Heavy-Vehicle-Networking-At-U-Tulsa/NMFTA-CAN-Logger/docs/AssembledPrototype.jpg

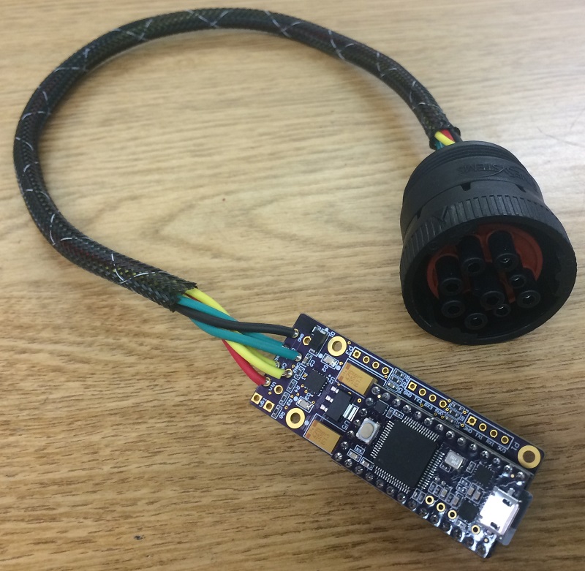
docs/AssembledPrototype.jpg
