Heavy-Vehicle-Networking-At-U-Tulsa/NMFTA-CAN-Logger/docs/BottomSideOfCANLoggerBoard.jpg

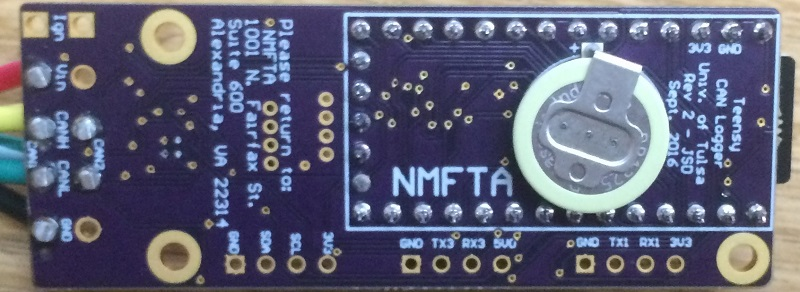
docs/BottomSideOfCANLoggerBoard.jpg
