Heavy-Vehicle-Networking-At-U-Tulsa/NMFTA-CAN-Logger/docs/Heavy Vehicle CAN Data Logger Collection Worksheet.docx

# Heavy Vehicle CAN Data Logger Collection Worksheet

Please fill out this data to assist in properly classifying the data contained on the SD Card with CAN data.

1. CAN Logger Serial number (e.g. TU01):
2. Vehicle Model Year: (YYYY)
3. Manufacture Date (e.g. Feb 09)
4. Vehicle Make (e.g. Freightliner)
5. Vehicle Model (e.g. Cascadia)
6. VIN: (17 Digits)
7. Engine Make (e.g. Detroit Diesel)
8. Engine Model (e.g. Series 60)
9. Engine Serial Number (e.g. 06R112345)
10. Brake Controller Make (e.g. Bendix)
11. Brake Controller Model (e.g. EC-60 ABS,PLC)
12. Brake Controller Serial Number (Optional)
13. Transmission Make (e.g. Eaton Fuller)
14. Transmission Model (e.g. RTLO-16713A)
15. Trans. Serial Number (Optional)
16. Telematics Make (e.g. Omnitracs)
17. Telematics Mode (e.g. MCP-200)
18. Telematics serial number (optional)
19. Date of installation: (MM/DD/YYYY)
20. Time of installation: (HH:MM am/pm tZone)
21. Date of removal: (MM/DD/YYYY)
22. Time of removal: (HH:MM am/pm tZone)
23. Approximate distance driven (miles)
24. Point of Contact for any questions
25. Point of Contact phone number:
26. Interesting facts about the test:

# LED Indicators and Troubleshooting

Data is being collected when the green LED is blinking. If the Red LED is flashing, there is an error. In case of an error, please insert the SD card and try again. If the Red LED stays on solid, even though there should be CAN data, the SD card may be full. Please try another SD card.

## Please Return To:

Urban K. Jonson
Chief Technology Officer
National Motor Freight Traffic Association, Inc.
1001 N. Fairfax St., Suite 600
Alexandria, VA 22314
E-mail: urban.jonson@nmfta.org
Phone: +1 (703) 838-1828

Using FexEx or UPS, please mail the SD cards. The cards will be returned.

GitHub\NMFTA-CAN-Logger\docs\Heavy Vehicle CAN Data Logger Collection Worksheet.docx
