Heavy-Vehicle-Networking-At-U-Tulsa/NMFTA-CAN-Logger/Utilities/Utility_Read_SD_Binaries_in_Python/TU02_001_signals.png

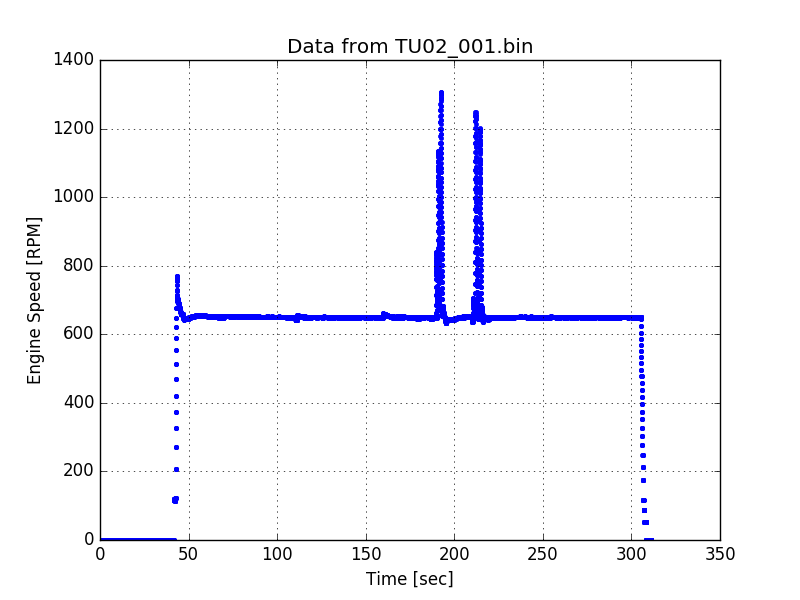
Utilities/Utility_Read_SD_Binaries_in_Python/TU02_001_signals.png
