Heavy-Vehicle-Networking-At-U-Tulsa/NMFTA-CAN-Logger/docs/TeensyCANLogger.pdf

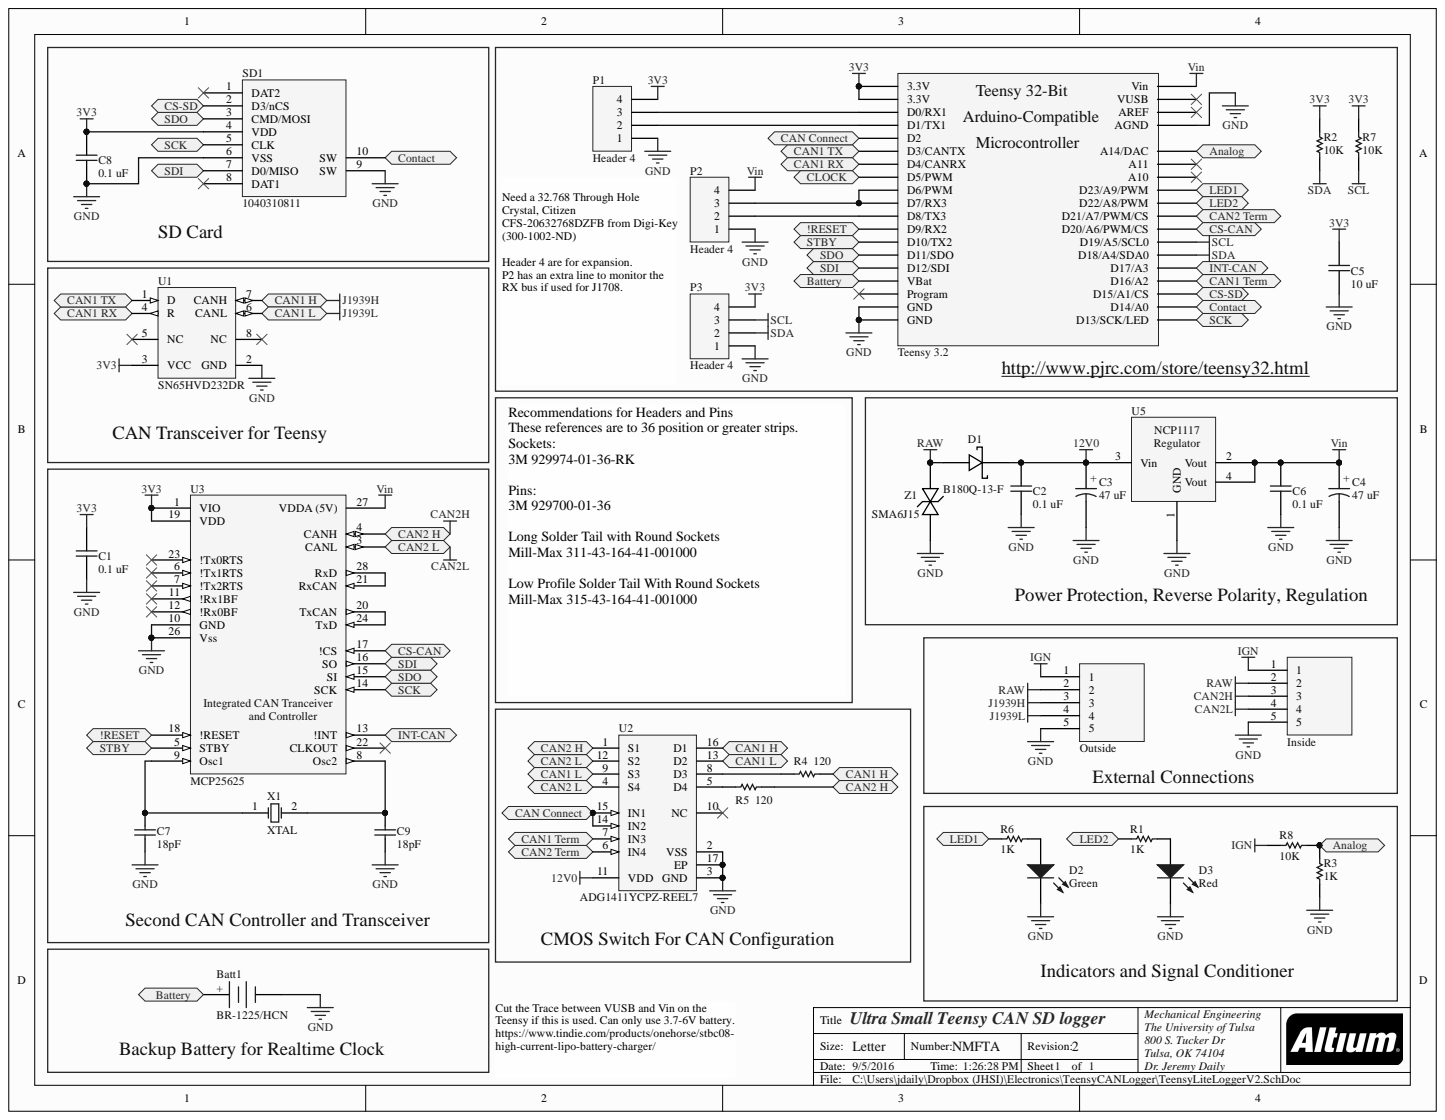
[picture p5: page 1]

Need a 32.768 Through Hole
Crystal, Citizen
CFS-20632768DZFB from Digi-Key

Header 4 are for expansion.
P2 has an extra line to monitor the
RX bus if used for J1708.

http://www.pjrc.com/store/teensy32.html

Recommendations for Headers and Pins
These references are to 36 position or greater strips.
Sockets:

RAW CAN Transceiver for Teensy

Long Solder Tail with Round Sockets
Mill-Max 311-43-164-41-001000

Low Profile Solder Tail With Round Sockets
Mill-Max 315-43-164-41-001000

Power Protection, Reverse Polarity, Regulation

Second CAN Controller and Transceiver

CMOS Switch For CAN Configuration

GND
Indicators and Signal Conditioner

Cut the Trace between VUSB and Vin on the
Teensy if this is used. Can only use 3.7-6V battery.
https://www.tindie.com/products/onehorse/stbc08-
high-current-lipo-battery-charger/

Ultra Small Teensy CAN SD logger Title | Mechanical Engineering The University of Tulsa 800 S. Tucker Dr Tulsa, OK 74104 Dr. Jeremy Daily

Backup Battery for Realtime Clock

Letter Size: | NMFTA Number: | 2 Revision:
Date: 9/5/2016 Time: 1:26:28 PM | | Sheet 1 of 1

C:\Users\jdaily\Dropbox (JHSI)\Electronics\TeensyCANLogger\TeensyLiteLoggerV2.SchDoc

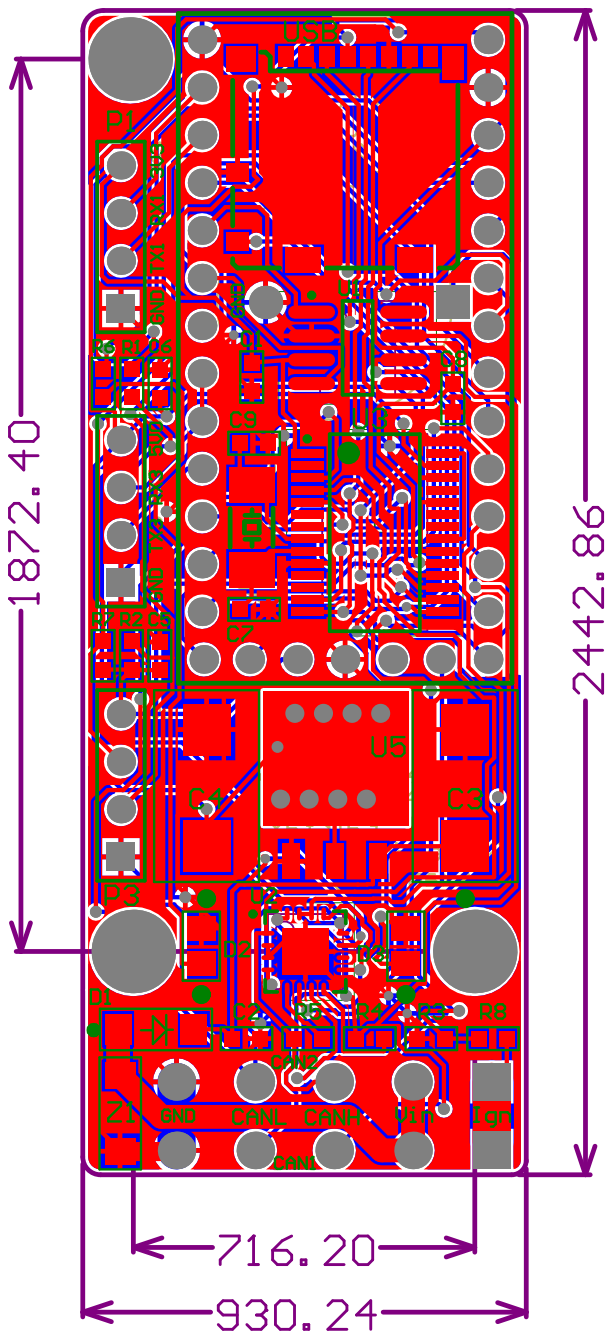
[picture p6: page 2]

Item#C#olumn Name Error:Manufac#Column Name Error:Manufacturer No | Quantity | #Column Name Error:Note | Designator | Description | Footprint | Comment | #Column Name Error:LibRe
1 | 1 | Batt1 | Lithium Battery Non-Rechargeable (Primary) 3V Coin, 12.5mm | BR-1225/HCN Coin Cell | BR-1225/HCN
2 | 1 | BRD1 | 32 Bit Arduino-Compatible Microcontroller Headers x 2 with 5 Pos | Teensy | Teensy 3.2
3 | 4 | C1, C2, C6, C8 | CAP CER 0.1UF 50V X7R 0603 | 0603 | 0.1 uF
4 | 2 | C3, C4 | Tantalum Capacitors - Solid SMD 35volts 47uF 10% ESR=300mOhms | 2917 | 47 uF
5 | 1 | C5 | 10µF 6.3V Ceramic Capacitor X5R 0603 (1608 Metric) 0.063" L x 0.031" W (1.60mm x 0.80mm) | 0603 | 10 uF
6 | 2 | C7, C9 | CAP CER 18PF 50V 5% NP0 0603 | 0603 | 18pF
7 | 1 | D1 | Diode Schottky 80V 1A Surface Mount SMA | SMA with A and K | B180Q-13-F
8 | 1 | D2 | Green 570nm LED Indication - Discrete 2.2V 0805 (2012 Metric) | 0805 Polarized | Green
9 | 1 | D3 | Red 633nm LED Indication - Discrete 2V 0805 (2012 Metric) | 0805 Polarized | Red
10 | 1 | J6 | Molex Mint Fit Jr 5 CKT VERT HEADER | 5 POS Vert MINI-FIT JR | Outside
11 | 1 | J7 | Molex Mint Fit Jr 5 CKT VERT HEADER | 5 POS Vert MINI-FIT JR | Inside
12 | 3 | P1, P2, P3 | Header, 4-Pin | HDR1X4 | Header 4
13 | 3 | R1, R3, R6 | RES SMD 1K OHM 1% 1/10W 0603 | 0603 | 1K
14 | 3 | R2, R7, R8 | RES SMD 10K OHM 1% 1/10W 0603 | 0603 | 10K
15 | 2 | R4, R5 | RES SMD 120 OHM 1% 1/10W 0603 | 0603 | 120
16 | 1 | SD1 | Molex 1040310811 | SD Holder Push-pull | 1040310811
17 | 1 | U1 | 1/1 Transceiver Half CAN 8-SOIC | D8_M | SN65HVD232DR
18 | 1 | U2 | 1.5 Ohm on Resistance, +/-15 V / +12 V / +/-5 V, iCMOS, Quad SPST Switch, 16-pin QFN (CP-16-13), Reel | ADI-CP-16-13_N | ADG1411YCPZ-REEL7
19 | 1 | U3 | CAN Interface IC CAN Controller with Int. Transceiver 28-SSOP | SOP65P780X200-28N | MCP25625
20 | 1 | U5 | Linear Voltage Regulator IC Positive Fixed 1 Output 5V 1A SOT-223 | SOT-223 | LDO1117
21 | 1 | X1 | CRYSTAL 16MHZ 18PF SMD | XTAL 2 pad | XTAL
22 | 1 | Z1 | TVS DIODE 15VWM 24.4VC SMA | SMA | SMA6J15
