Heavy-Vehicle-Networking-At-U-Tulsa/NMFTA-CAN-Logger/Utilities/Utility_Read_SD_Binaries_in_Python/TU02_001_signals_zoomed.pdf

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

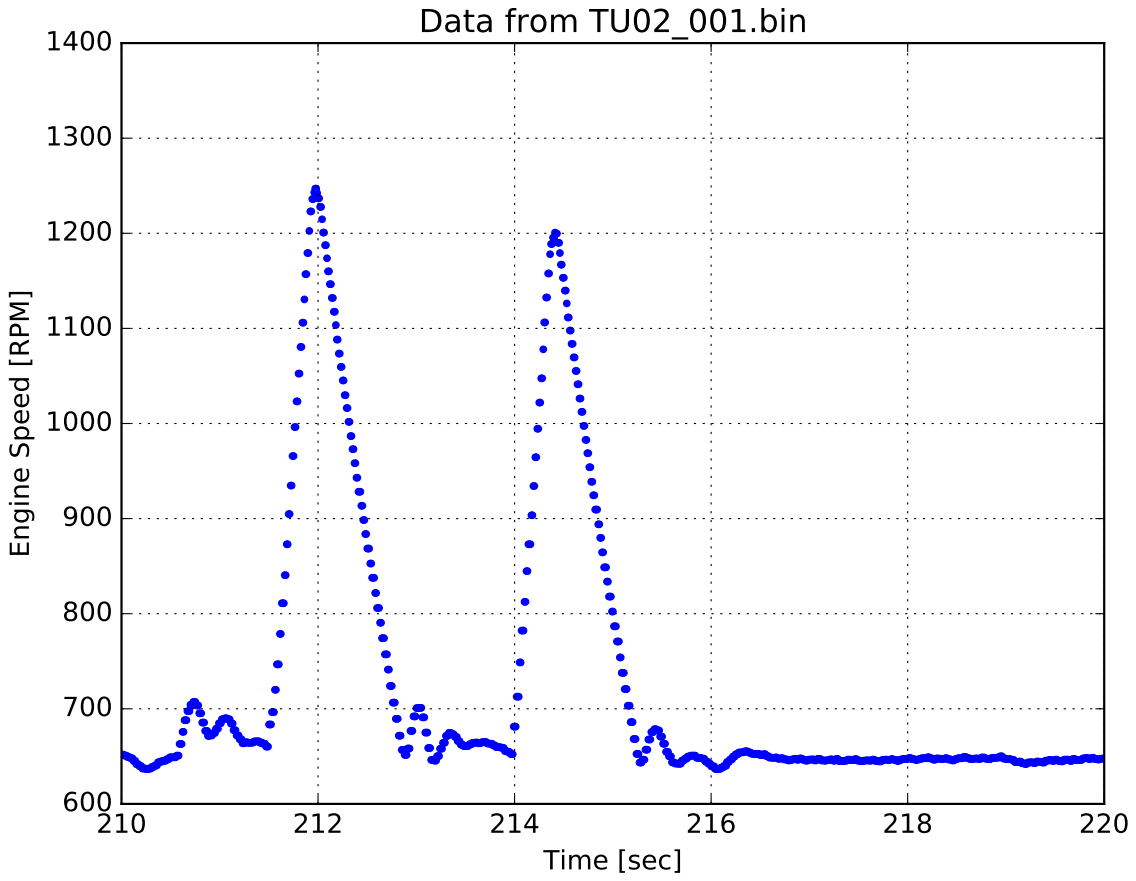
[picture p8: page 1]
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
