Heavy-Vehicle-Networking-At-U-Tulsa/NMFTA-CAN-Logger/_07_Low_Latency_Logger_with_Requests/_07_Low_Latency_Logger_with_Requests.ino

/*
 * NMFTA CAN Logger Project
 * 
 * Arduino Sketch to test the ability to receive CAN messages
 * 
 * Written By Dr. Jeremy S. Daily
 * The University of Tulsa
 * Department of Mechanical Engineering
 * 
 * 29 September 2016
 * 
 * Released under the MIT License
 *
 * Copyright (c) 2016        Jeremy S. Daily
 *
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
 * 
 * This program logs data to a binary file.  Functions are included
 * to convert the binary file to a csv text file.
 *
 * Samples are logged at regular intervals.  The maximum logging rate
 * depends on the quality of your SD card. 
 * 
 * Data is written to the file using a SD multiple block write command.
 * 
 * Much of this sketch was inspired by the examples from https://github.com/greiman/SdFat
 * 
 */

// log file base name.  Must be five characters or less. Change this line for each upload
// The first four characters should match the label on the cable.
#define FILE_BASE_NAME "TU01_"

//included libraries 
#include <SPI.h>
#include <SdFat.h>
#include <SdFatUtil.h>
//#include <StdioStream.h>
#include <FlexCAN.h>
#include <TimeLib.h>

// User data functions.  Modify these functions for your data items.
// Edit this include file to change data_t.
#include "UserDataType.h"  

const int millisBetweenRequests = 5000;

#define numRequests 4
const uint16_t PGNRequestList[numRequests] = {
  //65261, // Cruise Control/Vehicle Speed Setup
  //65214, // Electronic Engine Controller 4
  65259, // Component Identification
  65242, // Software Identification
  //65244, // Idle Operation
  65260, // Vehicle Identification
  //65255, // Vehicle Hours
  //65253, // Engine Hours, Revolutions
  //65257, // Fuel Consumption (Liquid)
  //65256, // Vehicle Direction/Speed
  //65254, // Time/Date
  //65211, // Trip Fan Information
  //65210, // Trip Distance Information
  //65209, // Trip Fuel Information (Liquid)
  //65207, // Engine Speed/Load Factor Information
  //65206, // Trip Vehicle Speed/Cruise Distance Information
  //65205, // Trip Shutdown Information
  //65204, // Trip Time Information 1
  //65200, // Trip Time Information 2
  //65250, // Transmission Configuration
  //65203, // Fuel Information (Liquid)
  //65201, // ECU History
  //65168, // Engine Torque History
  //64981, // Electronic Engine Controller 5
  //64978, // ECU Performance
  64965, // ECU Identification Information
  //65165  // Vehicle Electrical Power #2
};

uint8_t pgnIndex = 0;

#define numBaudRates 4
uint32_t baudRateList[numBaudRates] = {250000,500000,125000,1000000}; 
uint32_t baudrate = 250000; //default (may be overwritten with autobaud detection)

static CAN_message_t rxmsg,txmsg;

elapsedMicros microsecondsPerSecond;
elapsedMillis lastCANmessageTimer;
elapsedMillis LEDblinkTimer;
elapsedMillis requestTimer;

boolean redLEDstate;
boolean greenLEDstate;

//set up a display buffer
char displayBuffer[100]; 
char serialInput;

//Pin Definitions (See Schematics)
// SD chip select pin.
const uint8_t SD_CS_PIN = 15;

// Reset pin 
const uint8_t MCP_RESET_PIN = 9;

// standBy pin 
const uint8_t MCP_STDBY_PIN = 10;

// chip select pin 
const uint8_t MCP_CS_PIN = 20;

// chip select pin 
const uint8_t MCP_INT_PIN = 17;

// SD Card Contact Pin 
const uint8_t SD_CONTACT_PIN = 14;

//CAN Connect Pins
const uint8_t CAN_CONNECT_PIN = 2;
const uint8_t CAN1_TERMINATION_PIN = 16;
const uint8_t CAN2_TERMINATION_PIN = 21;

// The led blinks for fatal errors. The led goes on solid for SD write
// overrun errors and logging continues.
const uint8_t ERROR_LED_PIN = 22;
const uint8_t GREEN_LED_PIN = 23;


// Acquire a data record.
void acquireCANData(data_t* data) {
  data->timeStamp = now();
  data->usec = micros();
  data->ID =  rxmsg.id; 
  data->DLC = (rxmsg.len << 24) | (0x00FFFFFF & uint32_t(microsecondsPerSecond)); //This structure condenses storage
  memset(data->dataField,0xFF,8); //Set to 0xFF if not used.
  for (uint8_t i = 0; i < rxmsg.len; i++){
    data->dataField[i] = rxmsg.buf[i];  
  }
}

// Print a data record.
void printData(Print* pr, data_t* data) {
  time_t recordTime = data->timeStamp;
  uint32_t usecPerSec = data->DLC & 0x00FFFFFF;
  char timeString[100];
  sprintf(timeString,"%04d-%02d-%02d,%02d:%02d:%02d.%06d,",year(recordTime),month(recordTime),day(recordTime),hour(recordTime),minute(recordTime),second(recordTime),usecPerSec);
  pr->print(timeString);
  
  sprintf(timeString,"%10d.%06d,",data->timeStamp,usecPerSec);
  pr->print(timeString);
  
  pr->print(data->usec);
   
  char IDString[12];
  sprintf(IDString,",%08X,",data->ID);
  pr->print(IDString);
  pr->print((data->DLC & 0xFF000000) >> 24);
  for (int i = 0; i < 8; i++) {
    char entry[5];
    sprintf(entry,",%02X",data->dataField[i]);
    pr->print(entry);
  }
  pr->println();
}

// Print data header.
void printHeader(Print* pr) {
  pr->print(F("YYYY-MM-DD,HH:MM:SS.usec,"));
  pr->print(F("Unix timeStamp,"));
  pr->print(F("System uSecs,"));
  pr->print(F("ID,"));
  pr->print(F("DLC"));
  for (uint8_t i = 0; i < 8; i++) {
    pr->print(F(",B"));
    pr->print(i);
  }
  pr->println();
}



//------------------------------------------------------------------------------
// File definitions.
//
// Maximum file size in blocks.
// The program creates a contiguous file with FILE_BLOCK_COUNT 512 byte blocks.
// This file is flash erased using special SD commands.  The file will be
// truncated if logging is stopped early.
//const uint32_t FILE_BLOCK_COUNT = 256;
//const uint32_t FILE_BLOCK_COUNT = 2097152; //1 GB
const uint32_t FILE_BLOCK_COUNT = 4194304; //2 GB
//const uint32_t FILE_BLOCK_COUNT = 8388607; //4 GB - 512



//------------------------------------------------------------------------------
// Buffer definitions.
//
// The logger will use SdFat's buffer plus BUFFER_BLOCK_COUNT additional
// buffers.
//
#ifndef RAMEND
// Assume ARM. Use total of nine 512 byte buffers.
const uint8_t BUFFER_BLOCK_COUNT = 8;
//
#elif RAMEND < 0X8FF
#error Too little SRAM
//
#elif RAMEND < 0X10FF
// Use total of two 512 byte buffers.
const uint8_t BUFFER_BLOCK_COUNT = 1;
//
#elif RAMEND < 0X20FF
// Use total of five 512 byte buffers.
const uint8_t BUFFER_BLOCK_COUNT = 4;
//
#else  // RAMEND
// Use total of 13 512 byte buffers.
const uint8_t BUFFER_BLOCK_COUNT = 12;
#endif  // RAMEND

// Temporary log file.  Will be deleted if a reset or power failure occurs.
char TMP_FILE_NAME[13] = "tmp_data.bin";

// Size of file base name.  Must not be larger than five.
const uint8_t BASE_NAME_SIZE = sizeof(FILE_BASE_NAME) - 1;

SdFat sd;
SdBaseFile binFile;

char binName[13] = FILE_BASE_NAME "000.bin";

// Number of data records in a block.
const uint16_t DATA_DIM = (512 - 4)/sizeof(data_t);

//Compute fill so block size is 512 bytes.  FILL_DIM may be zero.
const uint16_t FILL_DIM = 512 - 4 - DATA_DIM*sizeof(data_t);

struct block_t {
  uint16_t count;
  uint16_t overrun;
  data_t data[DATA_DIM];
  uint8_t fill[FILL_DIM];
};


/*
 * ------------------------------------------------------------------------------
 * Function: getBaudRate
 * 
 * returns one of the predefined CAN bauds rates
 * 
 * This function will always run until a CAN message is received. Therefore, the first messages may not be captured if
 * the program starts on a live bus. 
*/
uint32_t getBaudRate() {
  rxmsg.timeout = 100;
  digitalWrite(LED_BUILTIN,HIGH);
  while (1){
    processSetTimeUtility();
    for(uint8_t i=0;i<numBaudRates;i++){
      uint32_t baudrate = baudRateList[i];
      Serial.print(F("Trying Baudrate of "));
      Serial.println(baudrate);
      FlexCAN testBus(baudrate);
      //Serial.println(F("Beginning test."));
      testBus.begin();
      if(testBus.read(rxmsg)){
        Serial.print("Baudrate is confirmed to be ");
        Serial.println(baudrate);
        digitalWrite(LED_BUILTIN,LOW);
        return baudrate;
      }
      else{
       testBus.end();
      }
      //Serial.println(F("Trying again."));
    }   
  }
}


//------------------------------------------------------------------------------
/*
 * User provided date time callback function.
 * See SdFile::dateTimeCallback() for usage.
 */
void dateTime(uint16_t* FATdate, uint16_t* FATtime) {
  // User gets date and time from GPS or real-time
  // clock in real callback function

  // return date using FAT_DATE macro to format fields
  *FATdate = FAT_DATE(year(), month(), day());

  // return time using FAT_TIME macro to format fields
  *FATtime = FAT_TIME(hour(), minute(), second());
}


const uint8_t QUEUE_DIM = BUFFER_BLOCK_COUNT + 2;

block_t* emptyQueue[QUEUE_DIM];
uint8_t emptyHead;
uint8_t emptyTail;

block_t* fullQueue[QUEUE_DIM];
uint8_t fullHead;
uint8_t fullTail;

// Advance queue index.
inline uint8_t queueNext(uint8_t ht) {
  return ht < (QUEUE_DIM - 1) ? ht + 1 : 0;
}
//==============================================================================
// Error messages stored in flash.
#define error(msg) errorFlash(F(msg))
//------------------------------------------------------------------------------
void errorFlash(const __FlashStringHelper* msg) {
  sd.errorPrint(msg);
  fatalBlink();
}
//------------------------------------------------------------------------------
//
void fatalBlink() {
  while (true) {
    if (ERROR_LED_PIN >= 0) {
      digitalWrite(ERROR_LED_PIN, HIGH);
      delay(80);
      digitalWrite(ERROR_LED_PIN, LOW);
      delay(80);
      
    }
  }
}
//==============================================================================
// Convert binary file to csv file.
void binaryToCsv() {
  uint8_t lastPct = 0;
  block_t block;
  uint32_t t0 = millis();
  uint32_t syncCluster = 0;
  SdFile csvFile;
  char csvName[13];

  if (!binFile.isOpen()) {
    Serial.println();
    Serial.println(F("No current binary file"));
    return;
  }
  binFile.rewind();
  // Create a new csvFile.
  strcpy(csvName, binName);
  strcpy(&csvName[BASE_NAME_SIZE + 4], ".csv");

  if (!csvFile.open(csvName, O_WRITE | O_CREAT | O_TRUNC)) {
    error("open csvFile failed");
  }
  Serial.println();
  Serial.print(F("Writing: "));
  Serial.print(csvName);
  Serial.println(F(" - type any character to stop"));
  printHeader(&csvFile);
  uint32_t tPct = millis();
  while (!Serial.available() && binFile.read(&block, 512) == 512) {
     
    uint16_t i;
    if (block.count == 0) {
      break;
    }
    if (block.overrun) {
      csvFile.print(F("OVERRUN,"));
      csvFile.println(block.overrun);
    }
    for (i = 0; i < block.count; i++) {
      printData(&csvFile, &block.data[i]);
    }
    if (csvFile.curCluster() != syncCluster) {
      csvFile.sync();
      syncCluster = csvFile.curCluster();
    }
    if ((millis() - tPct) > 1000) {
      uint8_t pct = binFile.curPosition()/(binFile.fileSize()/100);
      if (pct != lastPct) {
        tPct = millis();
        lastPct = pct;
        Serial.print(pct, DEC);
        Serial.println('%');
      }
    }
    if (Serial.available()) {
      break;
    }
  }
  csvFile.close();
  Serial.print(F("Done: "));
  Serial.print(0.001*(millis() - t0));
  Serial.println(F(" Seconds"));
}
//------------------------------------------------------------------------------
// read data file and check for overruns
void checkOverrun() {
  bool headerPrinted = false;
  block_t block;
  uint32_t bgnBlock, endBlock;
  uint32_t bn = 0;

  if (!binFile.isOpen()) {
    Serial.println();
    Serial.println(F("No current binary file"));
    return;
  }
  if (!binFile.contiguousRange(&bgnBlock, &endBlock)) {
    error("contiguousRange failed");
  }
  binFile.rewind();
  Serial.println();
  Serial.println(F("Checking overrun errors - type any character to stop"));
  while (binFile.read(&block, 512) == 512) {
    if (block.count == 0) {
      break;
    }
    if (block.overrun) {
      if (!headerPrinted) {
        Serial.println();
        Serial.println(F("Overruns:"));
        Serial.println(F("fileBlockNumber,sdBlockNumber,overrunCount"));
        headerPrinted = true;
      }
      Serial.print(bn);
      Serial.print(',');
      Serial.print(bgnBlock + bn);
      Serial.print(',');
      Serial.println(block.overrun);
    }
    bn++;
  }
  if (!headerPrinted) {
    Serial.println(F("No errors found"));
  } else {
    Serial.println(F("Done"));
  }
}
//------------------------------------------------------------------------------
// dump data file to Serial
void dumpData() {
  block_t block;
  if (!binFile.isOpen()) {
    Serial.println();
    Serial.println(F("No current binary file"));
    return;
  }
  binFile.rewind();
  Serial.println();
  Serial.println(F("Type any character to stop"));
  delay(100);
  printHeader(&Serial);
  while (!Serial.available() && binFile.read(&block , 512) == 512) {
  
    if (block.count == 0) {
      break;
    }
    if (block.overrun) {
      Serial.print(F("OVERRUN,"));
      Serial.println(block.overrun);
    }
    for (uint32_t i = 0; i < block.count; i++) {
      printData(&Serial, &block.data[i]);
    }
  }
  Serial.println(F("Done"));
}


//------------------------------------------------------------------------------
// log data
// max number of blocks to erase per erase call
uint32_t const ERASE_SIZE = 262144L;
void logData(uint32_t baudrate) {
  digitalWrite(ERROR_LED_PIN,HIGH);
  FlexCAN CANbus(baudrate);
  CANbus.begin();
  rxmsg.timeout = 0;
  
  
  uint32_t bgnBlock, endBlock;
  lastCANmessageTimer = 0;
  
  // Allocate extra buffer space.
  block_t block[BUFFER_BLOCK_COUNT];
  block_t* curBlock = 0;
  Serial.println();

  // Find unused file name.
  if (BASE_NAME_SIZE > 5) {
    error("FILE_BASE_NAME too long");
  }
  while (sd.exists(binName)) {
    if (binName[BASE_NAME_SIZE + 2] != '9') {
      binName[BASE_NAME_SIZE + 2]++;
    }
    else {
      binName[BASE_NAME_SIZE + 2] = '0';
      if (binName[BASE_NAME_SIZE + 1] != '9') {
        binName[BASE_NAME_SIZE + 1]++;
      }
      else {
        binName[BASE_NAME_SIZE+1] = '0';
        binName[BASE_NAME_SIZE]++;
      }
    }
    
   if (binName[BASE_NAME_SIZE] == '9' & binName[BASE_NAME_SIZE+1] == '9' & binName[BASE_NAME_SIZE+2] == '9') {
        error("Can't create file name");
    }
  }
//  memset(TMP_FILE_NAME,0,sizeof(TMP_FILE_NAME));
//  for(uint8_t i = 0; i<8; i++){
//    TMP_FILE_NAME[i] = random(65,91);  
//  }
//  strncat(TMP_FILE_NAME, ".tmp",4);
  
  
  // Create new file.
  Serial.print(F("Creating new file "));
  Serial.println(TMP_FILE_NAME);
  binFile.close();
  if (!binFile.createContiguous(sd.vwd(),TMP_FILE_NAME, 512 * FILE_BLOCK_COUNT)) {
    error("createContiguous failed");
  }
  // Get the address of the file on the SD.
  if (!binFile.contiguousRange(&bgnBlock, &endBlock)) {
    error("contiguousRange failed");
  }
  // Use SdFat's internal buffer.
  uint8_t* cache = (uint8_t*)sd.vol()->cacheClear();
  if (cache == 0) {
    error("cacheClear failed");
  }

  // Flash erase all data in the file.
  Serial.println(F("Initializing Temporary File"));
  uint32_t bgnErase = bgnBlock;
  uint32_t endErase;
  while (bgnErase < endBlock) {
    endErase = bgnErase + ERASE_SIZE;
    if (endErase > endBlock) {
      endErase = endBlock;
    }
    if (!sd.card()->erase(bgnErase, endErase)) {
      error("erase failed");
    }
    bgnErase = endErase + 1;
  }
  // Start a multiple block write.
  if (!sd.card()->writeStart(bgnBlock, FILE_BLOCK_COUNT)) {
    error("writeBegin failed");
  }
  // Initialize queues.
  emptyHead = emptyTail = 0;
  fullHead = fullTail = 0;

  // Use SdFat buffer for one block.
  emptyQueue[emptyHead] = (block_t*)cache;
  emptyHead = queueNext(emptyHead);

  // Put rest of buffers in the empty queue.
  for (uint8_t i = 0; i < BUFFER_BLOCK_COUNT; i++) {
    emptyQueue[emptyHead] = &block[i];
    emptyHead = queueNext(emptyHead);
  }

  //wait for a CAN message to show up
  Serial.println(F("Waiting for CAN Messages..."));
  while (CANbus.read(rxmsg) == 0) processSetTimeUtility(); //Set up the ability to set the realtime clock while waiting for a CAN message
  Serial.println(F("CAN Message Found."));
  Serial.println(F("Logging - type any character to stop"));
  // Wait for Serial Idle.
  Serial.flush();
  //while(Serial.available()) Serial.read();
  delay(10);
  uint32_t bn = 0;
  uint32_t t0 = millis();
  uint32_t t1 = t0;
  uint32_t overrun = 0;
  uint32_t overrunTotal = 0;
  uint32_t count = 0;
  uint32_t maxLatency = 0;
  int32_t diff;
//  // Start at a multiple of interval.
//  uint32_t logTime = micros()/LOG_INTERVAL_USEC + 1;
//  logTime *= LOG_INTERVAL_USEC;
  bool closeFile = false;

  
  digitalWrite(GREEN_LED_PIN,HIGH);
  digitalWrite(ERROR_LED_PIN,LOW);
  
  while (1) {
    if (Serial.available()) {
      closeFile = true;
      serialInput = Serial.read();
    }

    if (closeFile) {
      
      
      if (curBlock != 0 && curBlock->count >= 0) {
        // Put buffer in full queue.
        fullQueue[fullHead] = curBlock;
        fullHead = queueNext(fullHead);
        curBlock = 0;
      }
    } 
    else
    {
      if (curBlock == 0 && emptyTail != emptyHead) {
        curBlock = emptyQueue[emptyTail];
        emptyTail = queueNext(emptyTail);
        curBlock->count = 0;
        curBlock->overrun = overrun;
        overrun = 0;
      }

      if (curBlock == 0) {
        overrun++;
        Serial.print(F("Overrun: "));
        Serial.println(overrun);
      } 
      else 
      {
        if (CANbus.read(rxmsg)){
          acquireCANData(&curBlock->data[curBlock->count++]);
          lastCANmessageTimer = 0;

        }
        
        if (requestTimer >= millisBetweenRequests) {
          requestTimer = 0;
          uint16_t pgnToRequest = PGNRequestList[pgnIndex];
          pgnIndex++;
          if (pgnIndex > numRequests ) pgnIndex = 0;
      
          txmsg.ext = 1;
          txmsg.id = 0x18EA00F9; //request PGN
          txmsg.buf[0] = (pgnToRequest & 0x0000FF);
          txmsg.buf[1] = (pgnToRequest & 0x00FF00) >> 8 ;
          txmsg.buf[2] = (pgnToRequest & 0xFF0000) >> 16; //These are in reverse byte order.
          txmsg.len = 3;
          CANbus.write(txmsg);
        }
        
        if (LEDblinkTimer >= 500){
          LEDblinkTimer = 0; 
          greenLEDstate = !greenLEDstate;
          digitalWrite(GREEN_LED_PIN,greenLEDstate);
        }

        if (lastCANmessageTimer > 10000) closeFile = true; //Close the file after 10 seconds of CAN silence
        
        if (curBlock->count >= DATA_DIM) {
          //Serial.println(F("curBlock->count >= DATA_DIM"));
          fullQueue[fullHead] = curBlock;
          fullHead = queueNext(fullHead);
          curBlock = 0;
        }
      }
    }

    if (fullHead == fullTail) {
      //Serial.println(F("fullHead == fullTail"));
      // Exit loop if done.
      if (closeFile) {
        break;
      }
    } 
    else if (!sd.card()->isBusy()) {
      
      // Get address of block to write.
      block_t* pBlock = fullQueue[fullTail];
      fullTail = queueNext(fullTail);
      // Write block to SD.
      uint32_t usec = micros();
      if (!sd.card()->writeData((uint8_t*)pBlock)) {
        error("write data failed");
      }
      usec = micros() - usec;
      t1 = millis();
      if (usec > maxLatency) {
        maxLatency = usec;
      }
      count += pBlock->count;

      // Add overruns and possibly light LED.
      if (pBlock->overrun) {
        overrunTotal += pBlock->overrun;
        if (ERROR_LED_PIN >= 0) {
          digitalWrite(ERROR_LED_PIN, HIGH);
        }
      }
      // Move block to empty queue.
      emptyQueue[emptyHead] = pBlock;
      emptyHead = queueNext(emptyHead);
      bn++;
      if (bn == FILE_BLOCK_COUNT) {
        // File full so stop
        closeFile = true;
        break;
      }
    }
  }
  Serial.println(F("Closing Temp Buffer File."));
      
  if (!sd.card()->writeStop()) {
    error("writeStop failed");
  }
  digitalWrite(ERROR_LED_PIN, HIGH);
  digitalWrite(GREEN_LED_PIN, LOW);
  // Truncate file if recording stopped early.
  if (bn != FILE_BLOCK_COUNT) {
    Serial.println(F("Truncating file"));
    if (!binFile.truncate(uint32_t(512 * bn))) {
      error("Can't truncate file");
    }
  }
  if (!binFile.rename(sd.vwd(), binName)) {
    error("Can't rename file");
  }
  Serial.print(F("File renamed: "));
  Serial.println(binName);

  // Delete old tmp file.
  if (sd.exists(TMP_FILE_NAME)) {
    Serial.print(F("Deleting tmp file "));
    Serial.println(TMP_FILE_NAME);
    if (!sd.remove(TMP_FILE_NAME)) {
      error("Can't remove tmp file");
    }
  }
  
  Serial.print(F("Max block write usec: "));
  Serial.println(maxLatency);
  Serial.print(F("Record time sec: "));
  Serial.println(0.001*(t1 - t0), 3);
  Serial.print(F("Sample count: "));
  Serial.println(count);
  Serial.print(F("Samples/sec: "));
  Serial.println((1000.0)*count/(t1-t0));
  Serial.print(F("Overruns: "));
  Serial.println(overrunTotal);
  Serial.println(F("Done"));

  if (serialInput == 'd') dumpData();
  else if (serialInput == 'c') binaryToCsv();
  while(Serial.available()) Serial.read(); // flush the input buffer
  serialInput = ' ';
  
}
//------------------------------------------------------------------------------

time_t getTeensy3Time(){
  microsecondsPerSecond = 0;
  return Teensy3Clock.get();
}

void setup(void) {
  
  //Define the pin modes and outputs according to the schematic and datasheets
  pinMode(ERROR_LED_PIN, OUTPUT);
  pinMode(GREEN_LED_PIN, OUTPUT);
  pinMode(CAN1_TERMINATION_PIN, OUTPUT); 
  pinMode(CAN2_TERMINATION_PIN, OUTPUT);
  pinMode(CAN_CONNECT_PIN, OUTPUT);
  pinMode(MCP_RESET_PIN, OUTPUT);
  pinMode(MCP_STDBY_PIN, OUTPUT);
  pinMode(MCP_INT_PIN, OUTPUT);
  pinMode(MCP_CS_PIN, OUTPUT);
  
  
  pinMode(SD_CONTACT_PIN, INPUT_PULLUP);

  digitalWrite(CAN1_TERMINATION_PIN,HIGH); //HIGH is for an open switch
  digitalWrite(CAN2_TERMINATION_PIN,HIGH);
  digitalWrite(CAN_CONNECT_PIN,HIGH);
  digitalWrite(MCP_RESET_PIN,HIGH);
  digitalWrite(MCP_STDBY_PIN,HIGH);
  digitalWrite(MCP_CS_PIN,HIGH);
 
 
  Serial.begin(9600);
  digitalWrite(ERROR_LED_PIN,HIGH);
  digitalWrite(GREEN_LED_PIN,HIGH);
  delay(1000);
  digitalWrite(GREEN_LED_PIN,LOW);

  if(digitalRead(SD_CONTACT_PIN)) Serial.println("SD Card not Detected. Please insert formatted card and reboot.");
  else Serial.println("SD Card present.");
  
  setSyncProvider(getTeensy3Time);
  if (timeStatus()!= timeSet) {
    Serial.println("Unable to sync with the RTC");
  } else {
    Serial.println("RTC has set the system time");
  }
  setSyncInterval(1);
  char timeString[32];
  sprintf(timeString,"%04d-%02d-%02d %02d:%02d:%02d.%06d",year(),month(),day(),hour(),minute(),second(),uint32_t(microsecondsPerSecond));
  Serial.println(timeString);
  
  Serial.print(F("FreeRam: "));
  Serial.println(FreeRam());
  Serial.print(F("Records/block: "));
  Serial.println(DATA_DIM);
  if (sizeof(block_t) != 512) {
    error("Invalid block size");
  }
  
  // initialize file system.
  if (!sd.begin(SD_CS_PIN, SPI_FULL_SPEED)) {
    sd.initErrorPrint();
    fatalBlink();
  }
  // set date time callback function
  SdFile::dateTimeCallback(dateTime);
  
  truncateTempfiles();
  
  baudrate = getBaudRate(); //comment this line out to accept the default


  SdFile baudFile;
  baudFile.open("baudRate.txt", O_RDWR | O_CREAT | O_AT_END);
  sprintf(timeString,"%04d-%02d-%02dT%02d:%02d:%02d,%d",year(),month(),day(),hour(),minute(),second(),baudrate);
  baudFile.println(timeString);
  baudFile.close();
}

void loop(void) {
  logData(baudrate);
}


void truncateTempfiles(){
  digitalWrite(ERROR_LED_PIN,HIGH);
  digitalWrite(GREEN_LED_PIN,HIGH);
  if (sd.exists(TMP_FILE_NAME)) {
    Serial.println("Found exsiting temp file."); 
    
    SdBaseFile tempFile;
 
    tempFile.open(TMP_FILE_NAME, O_RDWR);
    
    byte someBytes[4];
    bool stillSearching = true;
    uint32_t highIndex = FILE_BLOCK_COUNT;
    uint32_t lowIndex = 0;
    
    tempFile.seekSet(0);
    for (int j = 0;j<4;j++){
      someBytes[j] = tempFile.read();
    }
    if (someBytes[0]==0xFF & someBytes[1]==0xFF & someBytes[2]==0xFF & someBytes[3]==0xFF){ // End is lower 
      Serial.println("Zero length temp file encountered. Ignoring.");
      if (!sd.remove(TMP_FILE_NAME)) {
        error("Can't remove tmp file");
      }
      return;
    }
    
    uint32_t fileIndex;
    while (stillSearching){ // Use bisection search to find the end of the file.
          fileIndex = (highIndex + lowIndex)/2;
          tempFile.seekSet(fileIndex*512L);
          for (int j = 0;j<4;j++){
            someBytes[j] = tempFile.read();
          }
          
          if (someBytes[0]==0xFF & someBytes[1]==0xFF & someBytes[2]==0xFF & someBytes[3]==0xFF){ // End is lower 
            highIndex = highIndex - (highIndex - lowIndex)/2;
          }
          else{ // end is higher
            lowIndex = lowIndex + (highIndex - lowIndex)/2;
          }
          if (highIndex - lowIndex < 2) stillSearching = false;
    }
    Serial.println("Trunating File.");
    if (!tempFile.truncate(uint32_t(512L * fileIndex))){
      error("Can't truncate file");
    }
    Serial.print("Truncated temp file to ");
    Serial.println( uint32_t(512L * fileIndex));
      
 
  // Find unused file name.
  if (BASE_NAME_SIZE > 5) {
    error("FILE_BASE_NAME too long");
  }
  while (sd.exists(binName)) {
    if (binName[BASE_NAME_SIZE + 2] != '9') {
      binName[BASE_NAME_SIZE + 2]++;
    }
    else {
      binName[BASE_NAME_SIZE + 2] = '0';
      if (binName[BASE_NAME_SIZE + 1] != '9') {
        binName[BASE_NAME_SIZE + 1]++;
      }
      else {
        binName[BASE_NAME_SIZE+1] = '0';
        binName[BASE_NAME_SIZE]++;
      }
    }
    
   if (binName[BASE_NAME_SIZE] == '9' & binName[BASE_NAME_SIZE+1] == '9' & binName[BASE_NAME_SIZE+2] == '9') {
        error("Can't create file name");
    }
  }
  Serial.print("Created new filename of ");
  Serial.println(binName);
  
   
  if (!tempFile.rename(sd.vwd(), binName)) {
    error("Can't rename file");
  }
  
  Serial.print(F("File renamed: "));
  Serial.println(binName);

  tempFile.close();

  }
  digitalWrite(GREEN_LED_PIN,LOW);
}

elapsedMillis displayCounter;

void processSetTimeUtility(){
  if (Serial.available()) {
    time_t t = processSyncMessage();
    if (t != 0) {
      Teensy3Clock.set(t); // set the RTC
      setTime(t);
    }
  }
  
  if (displayCounter >=1000){
    displayCounter = 0;
    char timeStamp[35];
    sprintf(timeStamp,"%04d-%02d-%02d %02d:%02d:%02d",year(),month(),day(),hour(),minute(),second());
    Serial.println(timeStamp);
  }  
}

/*  code to process time sync messages from the serial port   */
#define TIME_HEADER  "T"   // Header tag for serial time sync message
const uint32_t DEFAULT_TIME = 1357041600; // Jan 1 2013 

uint32_t processSyncMessage() {
  uint32_t pctime = 0L;
  
  if(Serial.find(TIME_HEADER)) {
     pctime = Serial.parseInt();
     if( pctime < DEFAULT_TIME) { // check the value is a valid time (greater than Jan 1 2013)
       pctime = 0L; // return 0 to indicate that the time is not valid
     }
  }
  return pctime;
}
