Heavy-Vehicle-Networking-At-U-Tulsa/NMFTA-CAN-Logger/_02_FlexCAN_Receive/_02_FlexCAN_Receive.ino

/*
 * NMFTA CAN Logger Project
 * 
 * Arduino Sketch to test the ability to receive CAN messages
 * 
 * Written By Dr. Jeremy S. Daily
 * The University of Tulsa
 * Department of Mechanical Engineering
 * 
 * 29 September 2016
 * 
 * Released under the MIT License
 *
 * Copyright (c) 2016        Jeremy S. Daily
 *
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
 * THE SOFTWARE IS PROVIDED "AS IS", WITHOUT WARRANTY OF ANY KIND, EXPRESS OR
 * IMPLIED, INCLUDING BUT NOT LIMITED TO THE WARRANTIES OF MERCHANTABILITY,
 * FITNESS FOR A PARTICULAR PURPOSE AND NONINFRINGEMENT. IN NO EVENT SHALL THE
 * AUTHORS OR COPYRIGHT HOLDERS BE LIABLE FOR ANY CLAIM, DAMAGES OR OTHER
 * LIABILITY, WHETHER IN AN ACTION OF CONTRACT, TORT OR OTHERWISE, ARISING FROM,
 * OUT OF OR IN CONNECTION WITH THE SOFTWARE OR THE USE OR OTHER DEALINGS IN THE
 * SOFTWARE.
 */

//Include the CAN libraries for the Teensy microprocessor
#include <FlexCAN.h>

//Include the ability to keep track of realtime
#include <TimeLib.h>

//initiate the CAN library at 250kbps for the CAN 1 or J1939
FlexCAN CANbus(250000);

//Set up the CAN data structures
static CAN_message_t rxmsg,txmsg;

//set up a counter for each received message
uint32_t rxCount = 0;


// Declare pin numbers based on the schematic
#define greenLED  23
#define redLED    22
#define CANconnect 2
#define CAN1termination 16
#define CAN2termination 21

//Keep track of the current state of the LEDs
boolean greenLEDstate = false;
boolean redLEDstate = true;
boolean LEDstate = true;

//Declare a millisecond timer to execute the switching of the LEDs on a set time
elapsedMillis toggleTimer;
elapsedMicros microsecondsPerSecond;

#define LEDtoggleTime 500

//set up a display buffer
char displayBuffer[100]; 

//set up a variable to keep track of the timestamp
time_t previousTime = 0;

//Declare a function to get the RTC clock
time_t getTeensy3Time(){
  return Teensy3Clock.get();
}

void setup() {
  //Set up the pin functions
  pinMode(greenLED,OUTPUT);
  pinMode(redLED,OUTPUT);
  pinMode(CANconnect,OUTPUT);
  pinMode(CAN1termination,OUTPUT);
  pinMode(CAN2termination,OUTPUT);
  pinMode(LED_BUILTIN,OUTPUT);

  digitalWrite(greenLED,greenLEDstate);
  digitalWrite(redLED,redLEDstate);
  digitalWrite(CANconnect,LOW);
  digitalWrite(CAN1termination,LOW);
  digitalWrite(CAN2termination,LOW);
  digitalWrite(LED_BUILTIN,LEDstate);

  Serial.begin(115200);
  while(!Serial); //remove this line if not being used with a serial console.
  
  // set the Time library to use Teensy 3.0's RTC to keep time
  setSyncProvider(getTeensy3Time);
  //Set System Time
  if (timeStatus()!= timeSet) {
    Serial.println(F("Unable to sync with the RTC"));
  } 
  else {
    Serial.println(F("RTC has set the system time"));
  }
  //print the time:
  sprintf(displayBuffer,"Current Time:\t%04i-%02i-%02i %02i:%02i:%02i",year(),month(),day(),hour(),minute(),second());
  Serial.println(displayBuffer); 


  //before entering the loop, set the microsecondprevious time
  previousTime = now();
  //synchronize the millisecondPerSecond timer
  while (now() - previousTime < 1){
    microsecondsPerSecond = 0;
  }  

  
  //start the CAN access
  CANbus.begin();
  rxmsg.timeout = 0;
  
  Serial.println(F("Teensy 3.2 Flex CAN to Serial Receive Test."));
 
  //print a header
  sprintf(displayBuffer,"%10s %4s-%2s-%2s %2s:%2s:%2s.%06s %8s %1s","Count","YYYY","MM","DD","hh","mm","ss","micros","CAN ID","N");
  Serial.print(displayBuffer); 
  for (uint8_t i = 1; i<9;i++){ //label the byte columns according to J1939 (i.e. start at 1 instead of 0)
    char byteDigits[7]; //declare a byte display array
    sprintf(byteDigits," B%i",i);
    Serial.print(byteDigits); 
  }
  Serial.println();
   
}

void loop() {
  
  //check to see if the number of seconds has changed to reset the millisecond timer for each second
  if (now() - previousTime == 1){
    previousTime = now();
    microsecondsPerSecond = 0;
  }

  //Read and display a CAN Message
  if(CANbus.read(rxmsg)){
    rxCount++;
    
    uint32_t ID = rxmsg.id;
    uint8_t len = rxmsg.len;
    
    sprintf(displayBuffer,"%10i %04i-%02i-%02i %02i:%02i:%02i.%06d %08X %1i",rxCount,year(),month(),day(),hour(),minute(),second(),int(microsecondsPerSecond),ID,len);
    Serial.print(displayBuffer); 
      
    for (uint8_t i = 0; i<len;i++){ 
      char byteDigits[4]; 
      sprintf(byteDigits," %02X",rxmsg.buf[i]);
      Serial.print(byteDigits); 
    }
    Serial.println();
  }
  
  
  if (toggleTimer >= LEDtoggleTime){
    toggleTimer = 0;
    greenLEDstate = !greenLEDstate;
    redLEDstate = !redLEDstate;
    LEDstate = !LEDstate;
    digitalWrite(greenLED,greenLEDstate);
    digitalWrite(redLED,redLEDstate);
    digitalWrite(LED_BUILTIN,LEDstate);
  }
}
