Heavy-Vehicle-Networking-At-U-Tulsa/NMFTA-CAN-Logger/(commit log)

2016-09-30 Initial Commit with Time Setting and LED Flasher
2016-10-31 Added Requests and Python Parser
    [SampleCounterData.csv]
2016-11-09 Plotting Engine RPM
    Added real data from a running truck.
    [TU02_001_signal.csv]
